Spico197/WirelessCard/(commit log)

2018-06-12 add a button-usart-hmi example
2018-06-14 Use correct separator in keywords.txt
    The Arduino IDE currently requires the use of a single true tab separator between the name and identifier. Without a tab the keyword is not highlighted.
    Reference:
    https://github.com/arduino/Arduino/wiki/Arduino-IDE-1.5:-Library-specification#keywords
